technoblogy/proto-power-supply/README.md

# Proto Power Supply
A portable breadboard-friendly adjustable power supply, designed as an ideal supply for Arduino projects and other low-power circuits. For more information see: http://www.technoblogy.com/show?LBR
