technoblogy/proto-power-supply/ProtoPowerSupply.brd

## EAGLE design ProtoPowerSupply.brd (2017-11-04)

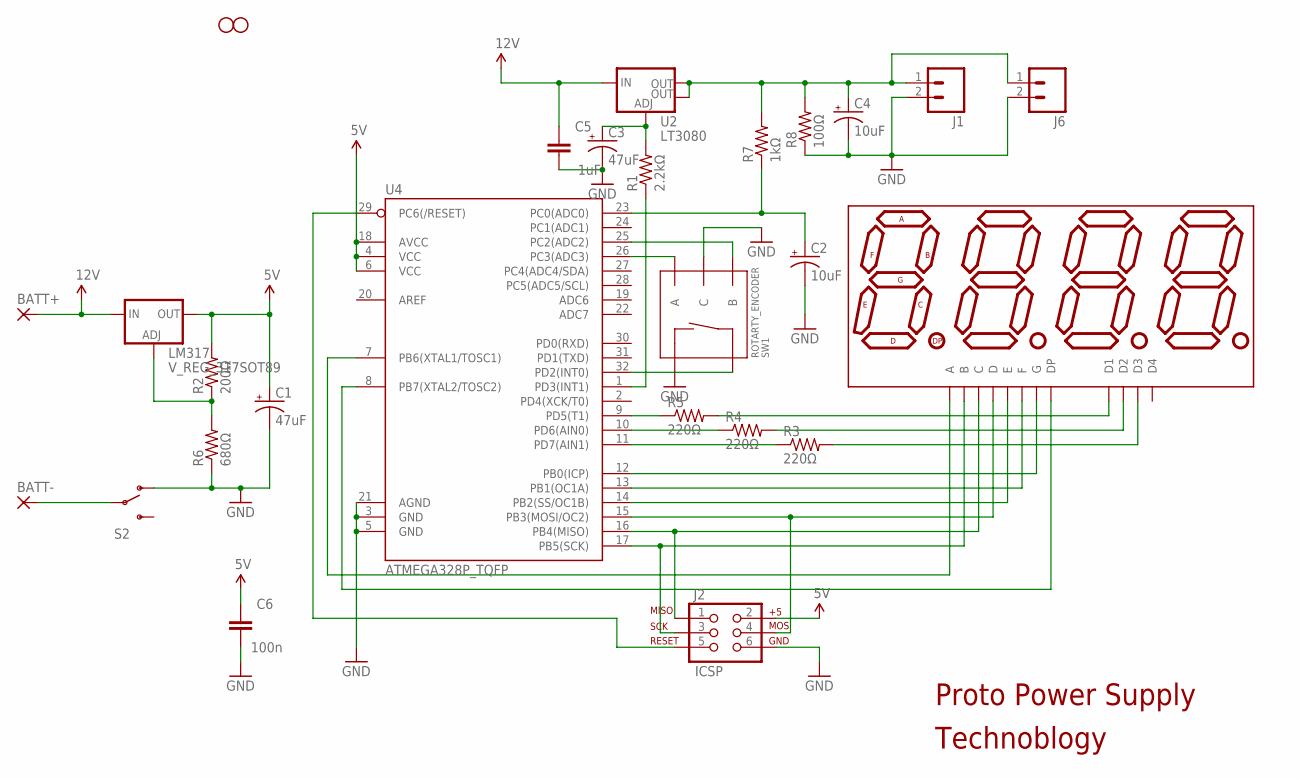
[picture p1: schematic ProtoPowerSupply.sch]

Parts:
BATT+: 1,6/0,9
BATT-: 1,6/0,9
C1, C3: 47uF; CPOL-RADIAL-10UF-25V
C2, C4: 10uF; CPOL-RADIAL-10UF-25V
C5: 1uF; 0603-CAP
C6: 100n; 0603-CAP
DISP1: KYX-2381
J1, J6: M021X02_NO_SILK; 1X02_NO_SILK
J2: ICSP; 2X3
JP4, JP5: STAND-OFF
LM317: V_REG_317SOT89; SOT89
R1: 2.2kΩ; R0805
R2: 200Ω; R0805
R3, R4, R5: 220Ω; R0805
R6: 680Ω; R0805
R7: 1kΩ; R0805
R8: 100Ω; R0805
S2: SWITCH-SPDTPTH; SWITCH-SPDT
SW1: ROTARTY_ENCODER; ROTARY_ENC_PLAIN
U2: LT3080; SOT223
U4: ATMEGA328P_TQFP; TQFP32-08

Connections:
5V: C1.1 (+), C6.1, J2.2, LM317.2 (OUT), R2.2, U4.4 (VCC), U4.6 (VCC), U4.18 (AVCC)
12V: BATT+.1, C5.1, LM317.3 (IN), U2.3 (IN)
GND: C1.2 (-), C2.2 (-), C3.2 (-), C4.2 (-), C5.2, C6.2, J1.2, J2.6, J6.2, R6.1, R8.1, S2.1 (O), SW1.C, SW1.SW-, U4.3 (GND), U4.5 (GND), U4.21 (AGND)
unnamed: DISP1.5 (G), U4.12 (PB0(ICP))
unnamed: C2.1 (+), R7.1, U4.23 (PC0(ADC0))
unnamed: C3.1 (+), R1.2, U2.1 (ADJ)
unnamed: BATT-.1, S2.2
unnamed: DISP1.10 (F), U4.13 (PB1(OC1A))
unnamed: DISP1.1 (E), U4.14 (PB2(SS/OC1B))
unnamed: DISP1.2 (D), J2.4, U4.15 (PB3(MOSI/OC2))
unnamed: DISP1.4 (C), J2.1, U4.16 (PB4(MISO))
unnamed: DISP1.7 (B), J2.3, U4.17 (PB5(SCK))
unnamed: DISP1.11 (A), U4.7 (PB6(XTAL1/TOSC1))
unnamed: DISP1.12 (D1), R5.2
unnamed: DISP1.3 (DP), U4.8 (PB7(XTAL2/TOSC2))
unnamed: DISP1.9 (D2), R4.2
unnamed: DISP1.8 (D3), R3.2
unnamed: R5.1, U4.9 (PD5(T1))
unnamed: R4.1, U4.10 (PD6(AIN0))
unnamed: R3.1, U4.11 (PD7(AIN1))
unnamed: SW1.B, U4.25 (PC2(ADC2))
unnamed: SW1.SW+, U4.32 (PD2(INT0))
unnamed: SW1.A, U4.26 (PC3(ADC3))
unnamed: J2.5, U4.29 (PC6(/RESET))
unnamed: R1.1, U4.1 (PD3(INT1))
unnamed: C4.1 (+), J1.1, J6.1, R7.2, R8.2, U2.2 (OUT), U2.4 (OUT)
unnamed: LM317.1 (ADJ), R2.1, R6.2

Notes on the sheet:
Proto Power Supply
Technoblogy

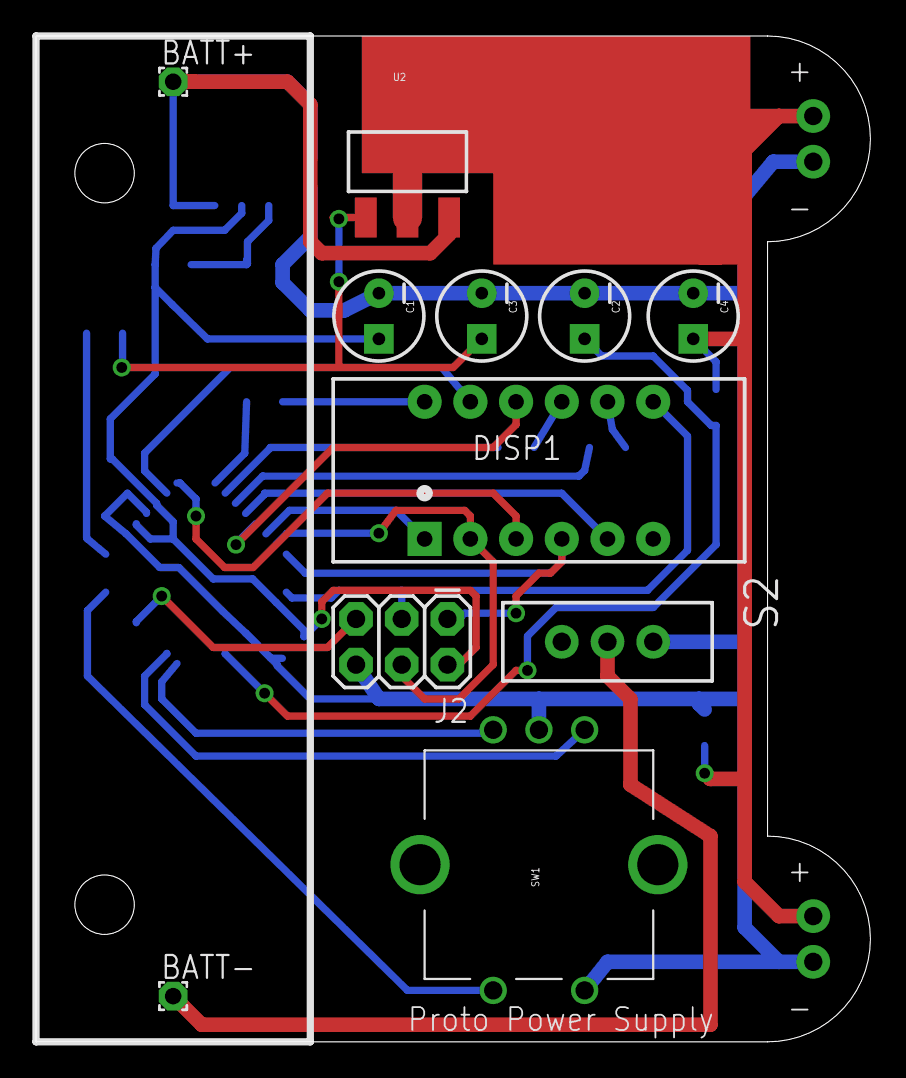
[picture p2: board ProtoPowerSupply.brd from above]

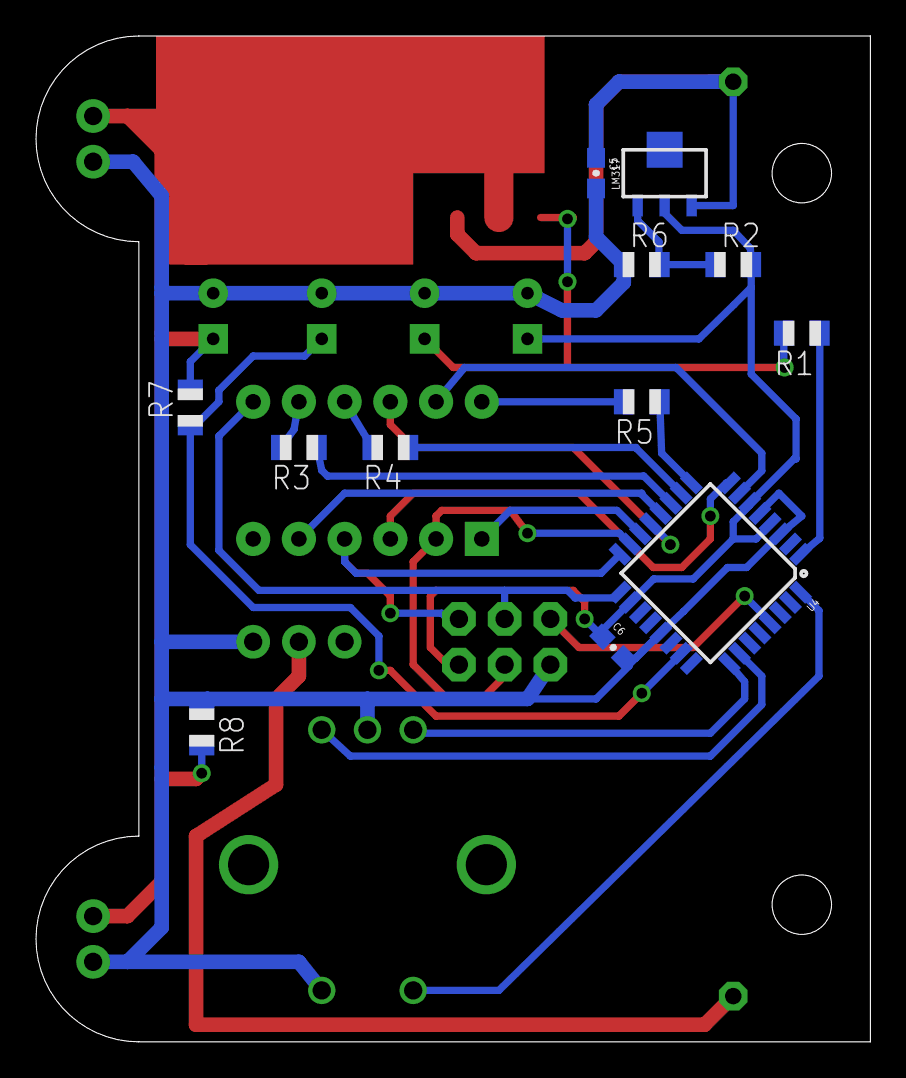
[picture p3: board ProtoPowerSupply.brd from below]

Board: 2 copper layers, 46.4 x 55.9 mm, 27 parts (12 on the bottom side), 27 nets.
