technoblogy/proto-power-supply/(commit log)

2017-11-04 Version 1 - 4th November 2017
    [ProtoPowerSupply.brd, ProtoPowerSupply.sch]
2018-04-02 Changed recommended fuse settings
